andreas-dd/SmartHome/README.md

# SmartHome

## [HB-UNI-Sen-CAP-MOIST-Complete](HB-UNI-Sen-CAP-MOIST-Complete)
Ein kompakter Bodenfeuchtesensor komplett auf einer einzigen Platine inkl. kleinem Gehäuse.
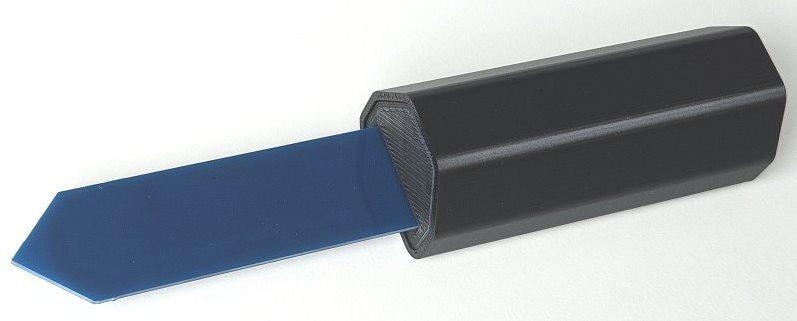
[picture p1: HB-UNI-Sen-CAP-MOIST-Complete/images/Sensor.jpg]
Bild
