andreas-dd/SmartHome/HB-UNI-Sen-CAP-MOIST-Complete/Gehaeuse/Sockel.stl

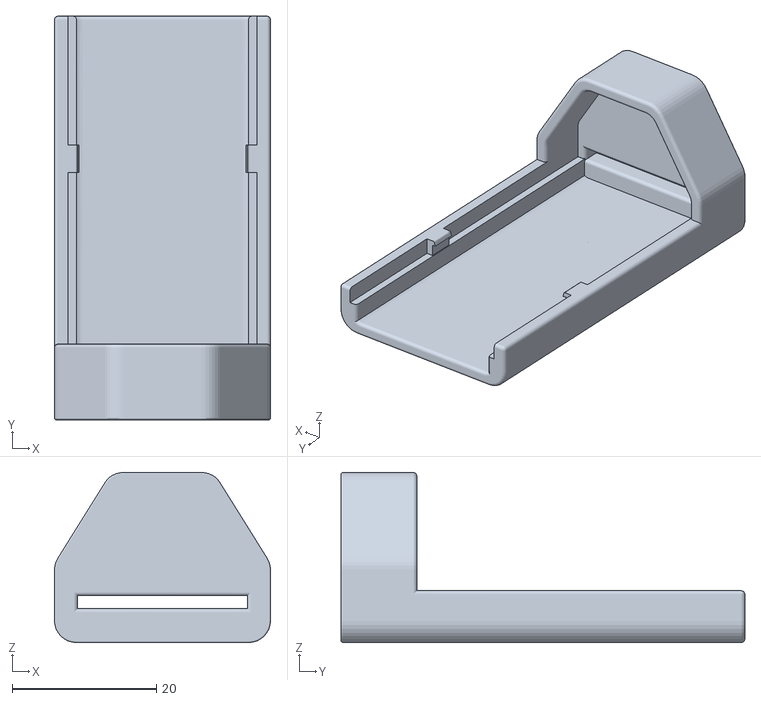
[picture p13: CAD file, 2026-03-24]
HB-UNI-Sen-CAP-MOIST-Complete/Gehaeuse/Sockel.stl
30.0 x 56.0 x 23.6
