andreas-dd/SmartHome/HB-UNI-Sen-CAP-MOIST-Complete/Gehaeuse/Kappe.stl

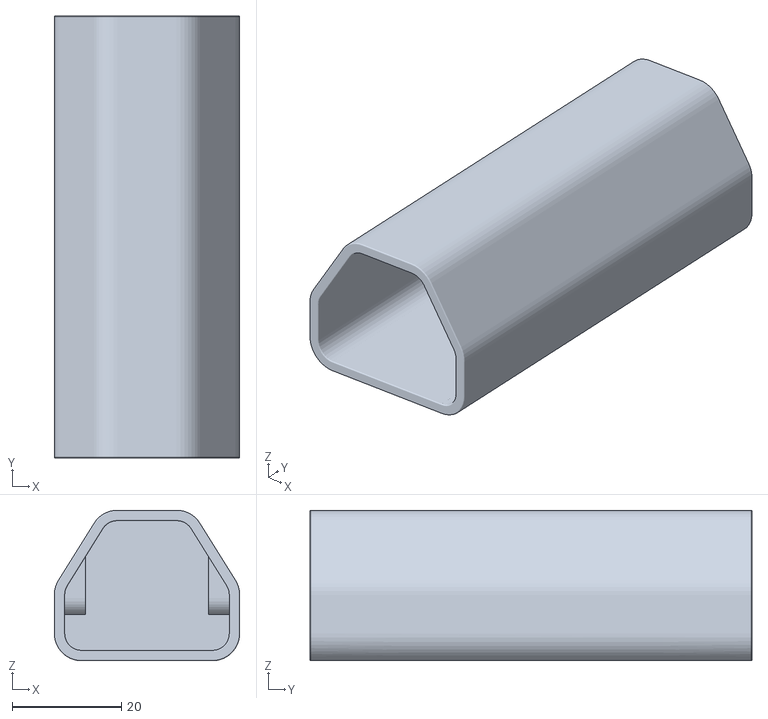
[picture p14: CAD file, 2026-03-24]
HB-UNI-Sen-CAP-MOIST-Complete/Gehaeuse/Kappe.stl
34.0 x 81.0 x 27.6
