andreas-dd/SmartHome/HB-UNI-Sen-CAP-MOIST-Complete/Gehaeuse/Antennenhalter.stl

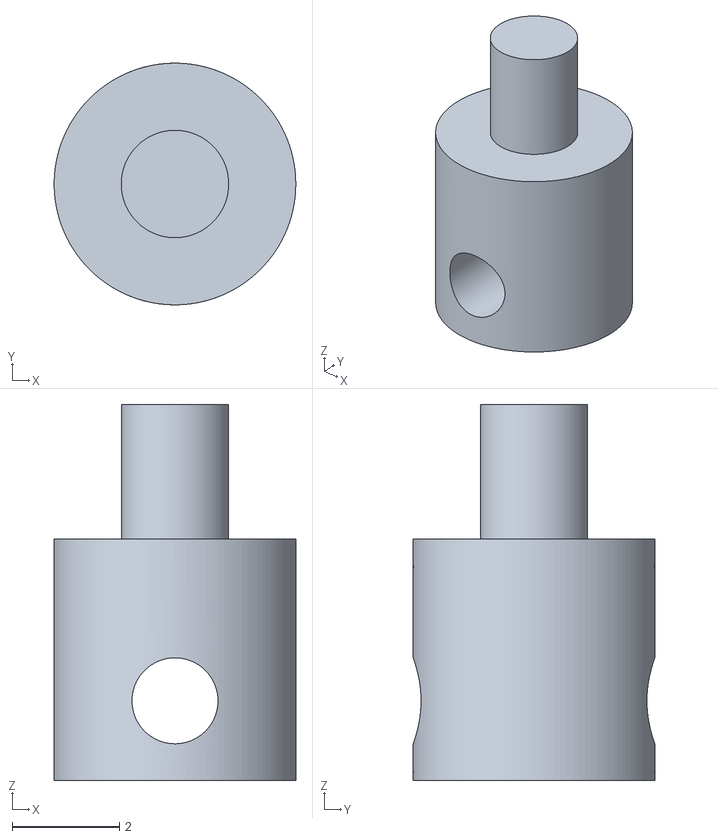
[picture p15: CAD file, 2026-03-24]
HB-UNI-Sen-CAP-MOIST-Complete/Gehaeuse/Antennenhalter.stl
4.50 x 4.50 x 7.00
