andreas-dd/SmartHome/HB-UNI-Sen-CAP-MOIST-Complete/Platine/HB-UNI-Sen-CAP-MOIST-Complete.pdf

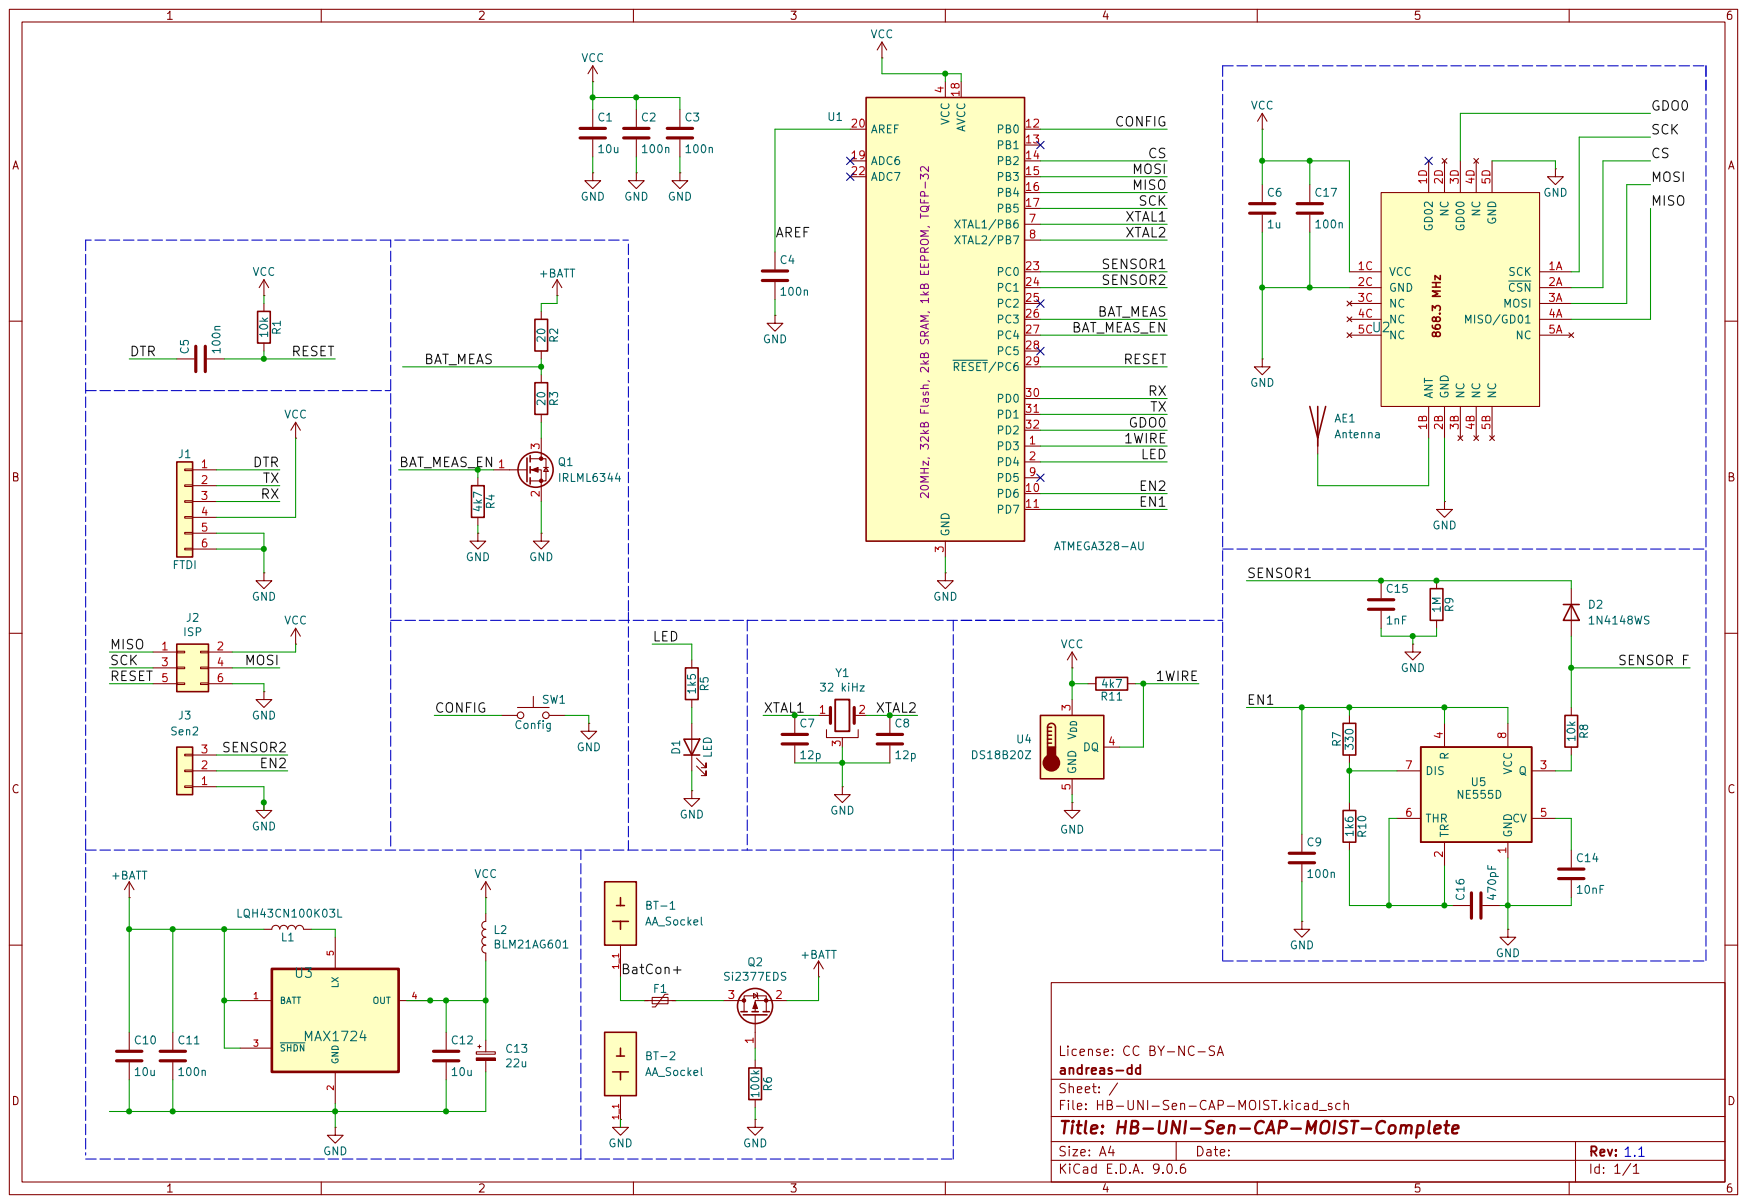
[picture p16: page 1]
