andreas-dd/SmartHome/HB-UNI-Sen-CAP-MOIST-Complete/Platine/Rückseite.pdf

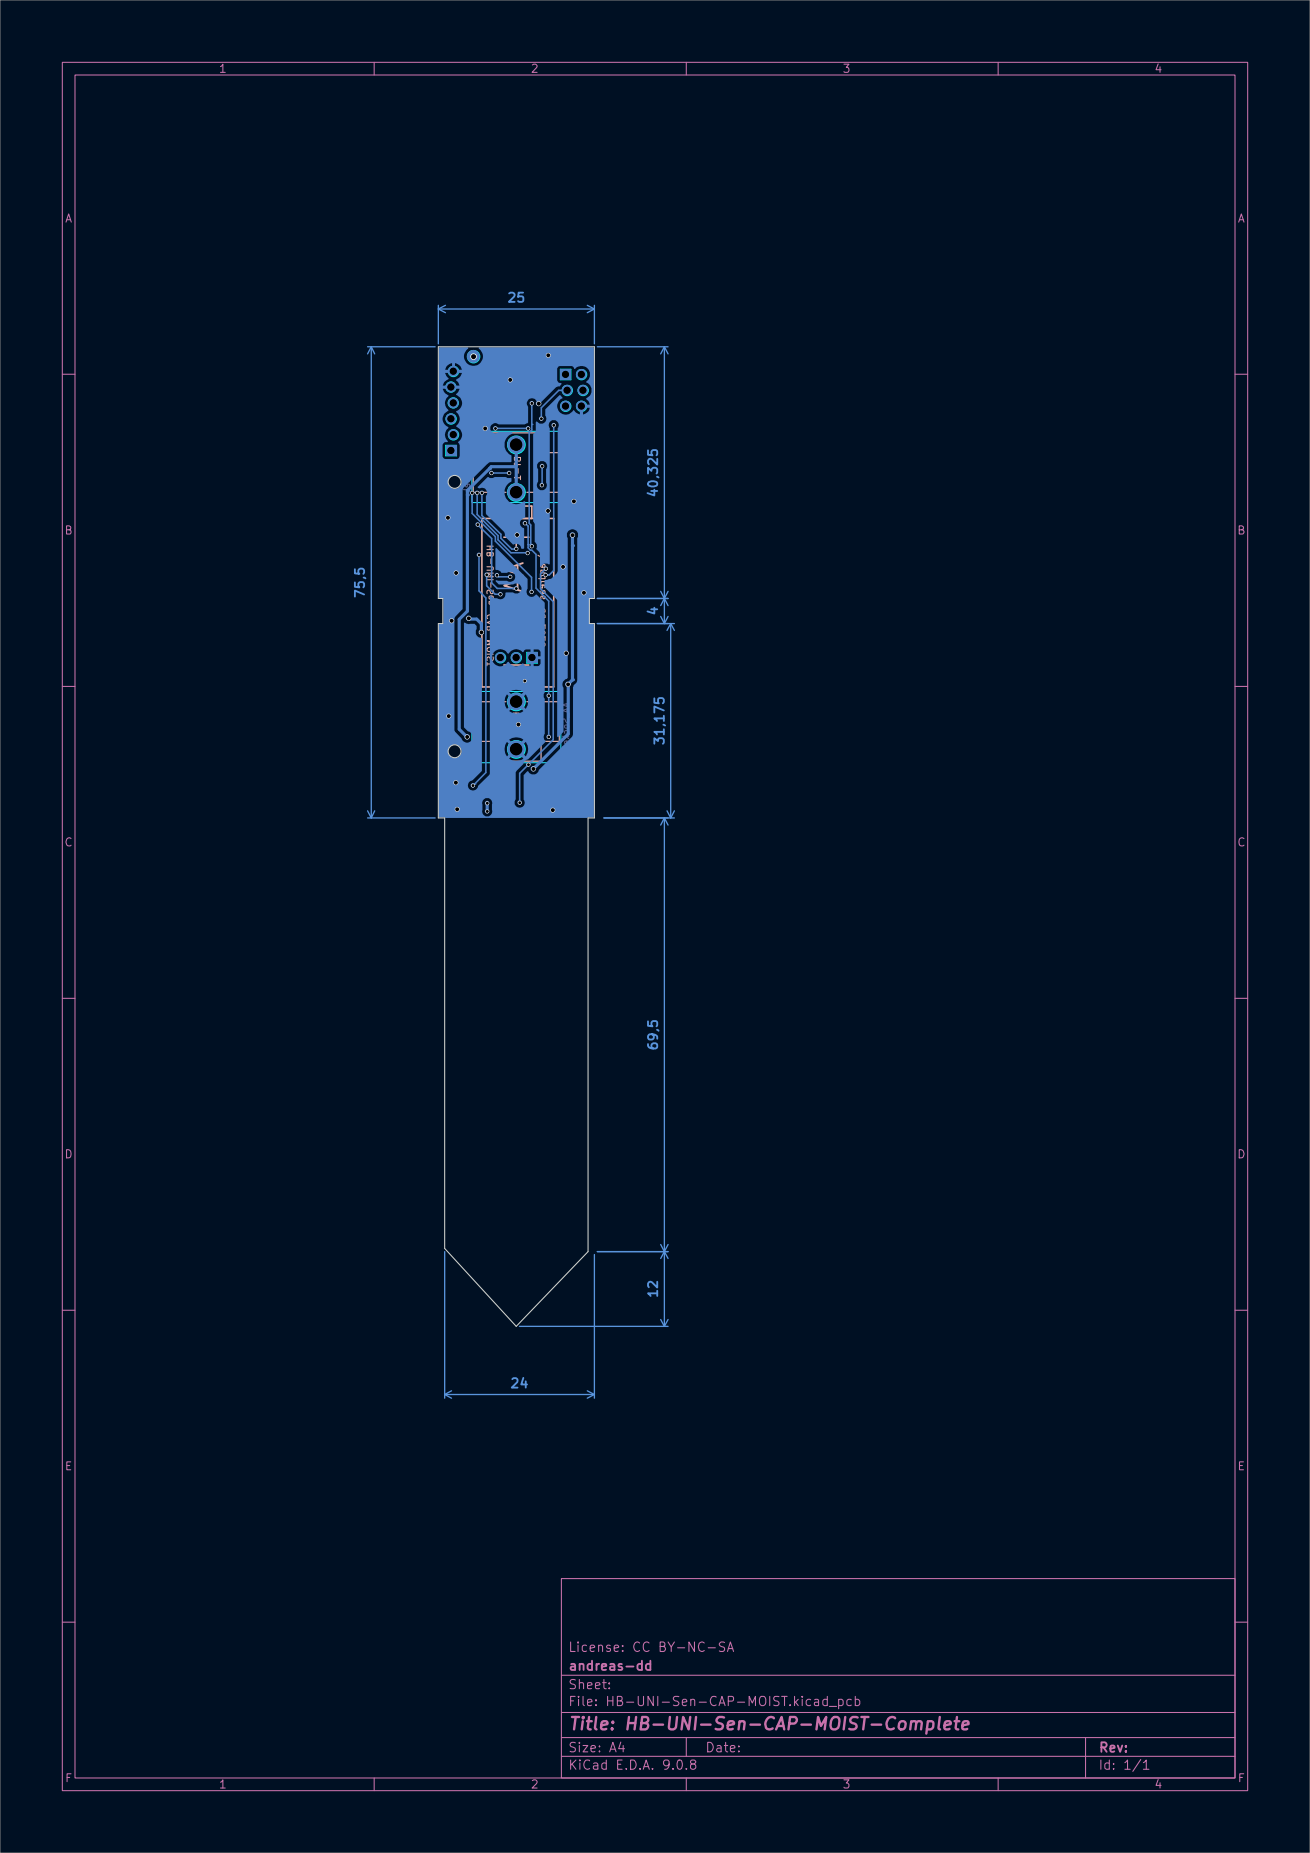
[picture p17: page 1]
