andreas-dd/SmartHome/HB-UNI-Sen-CAP-MOIST-Complete/Platine/Vorderseite.pdf

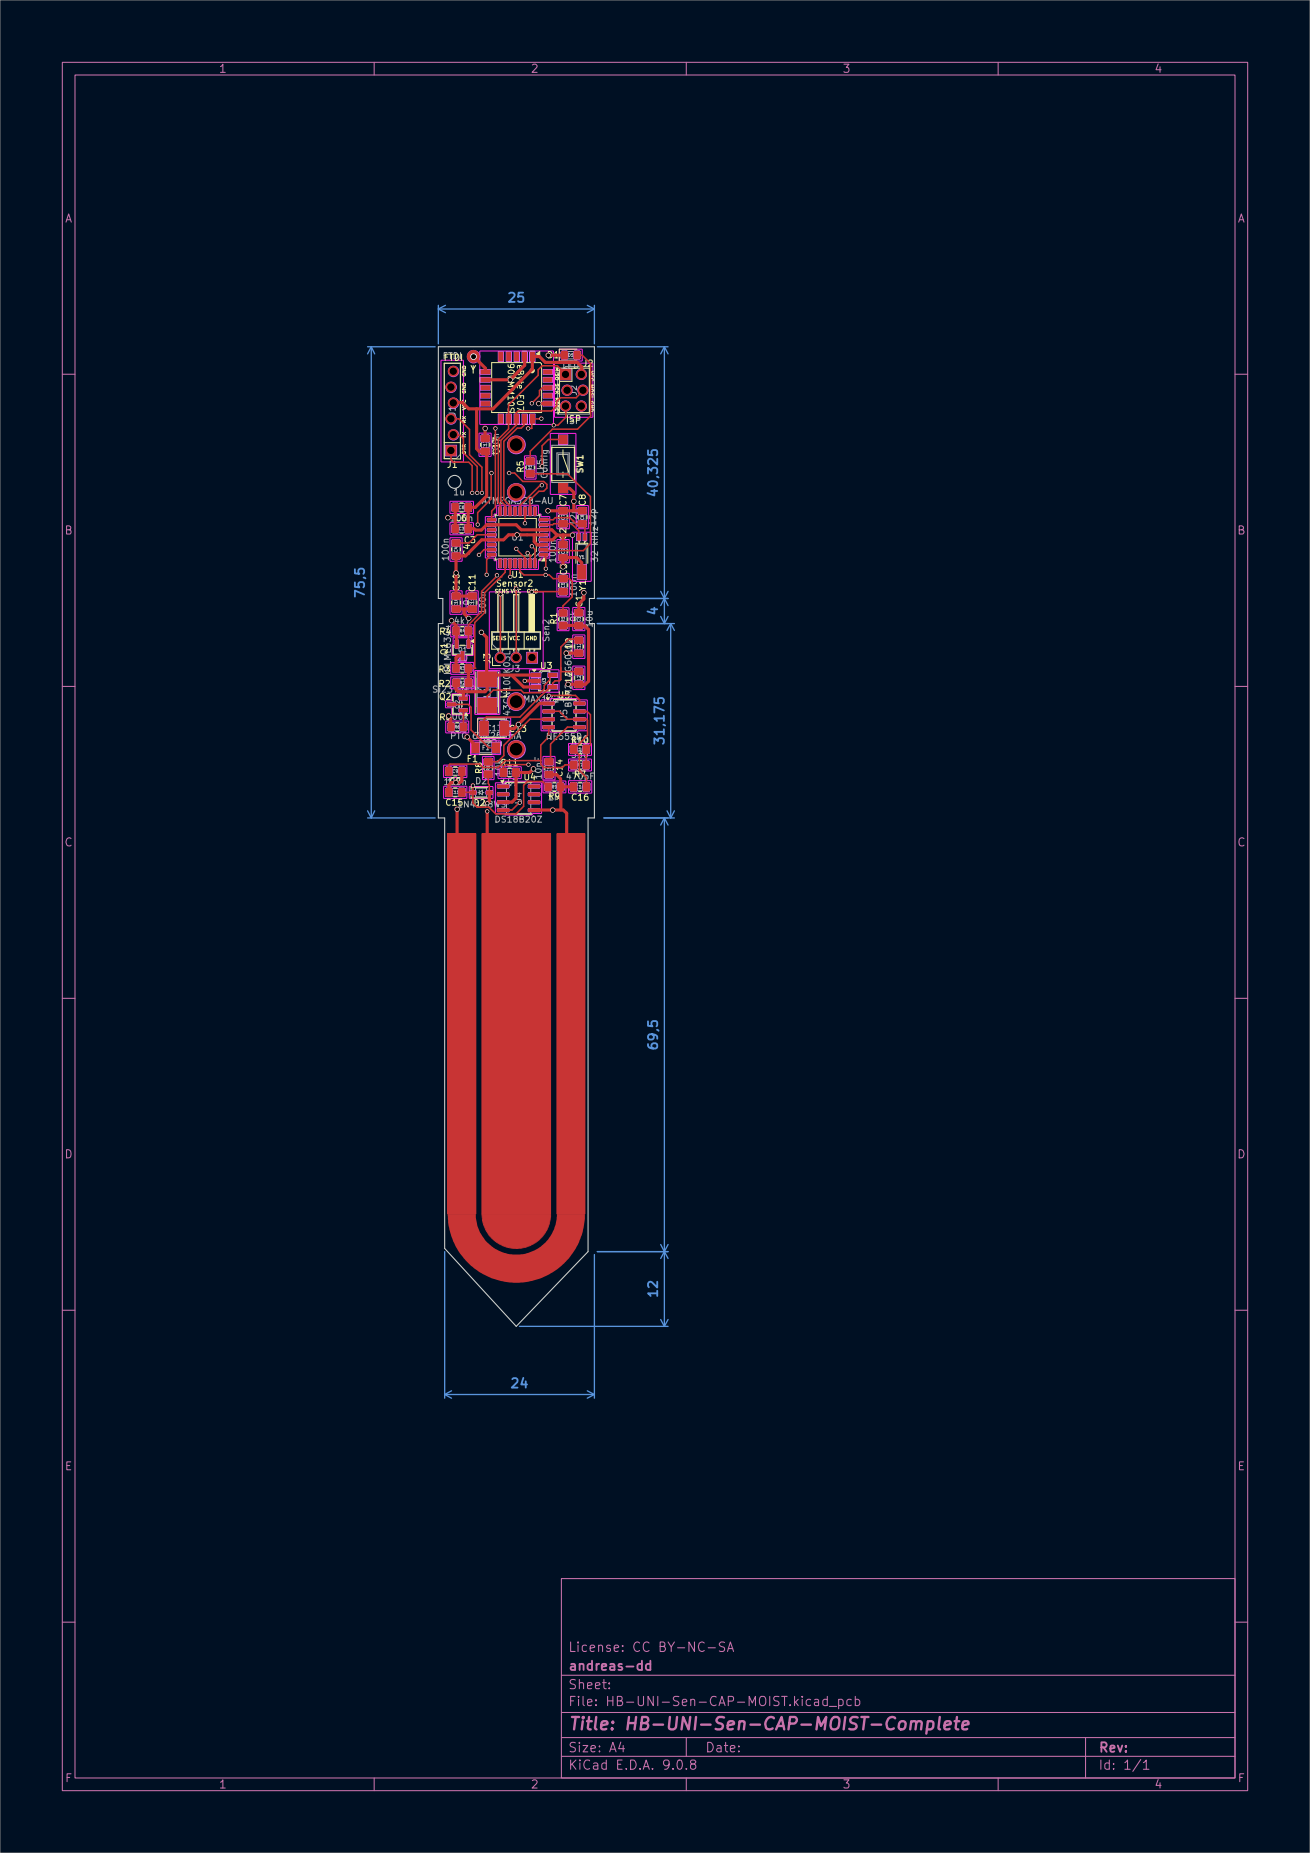
[picture p18: page 1]
