andreas-dd/SmartHome/HB-UNI-Sen-CAP-MOIST-Complete/Platine/HB-UNI-Sen-CAP-MOIST-Complete.kicad_pcb

## KiCad design HB-UNI-Sen-CAP-MOIST-Complete/Platine/HB-UNI-Sen-CAP-MOIST-Complete.kicad_pcb (2026-03-24)

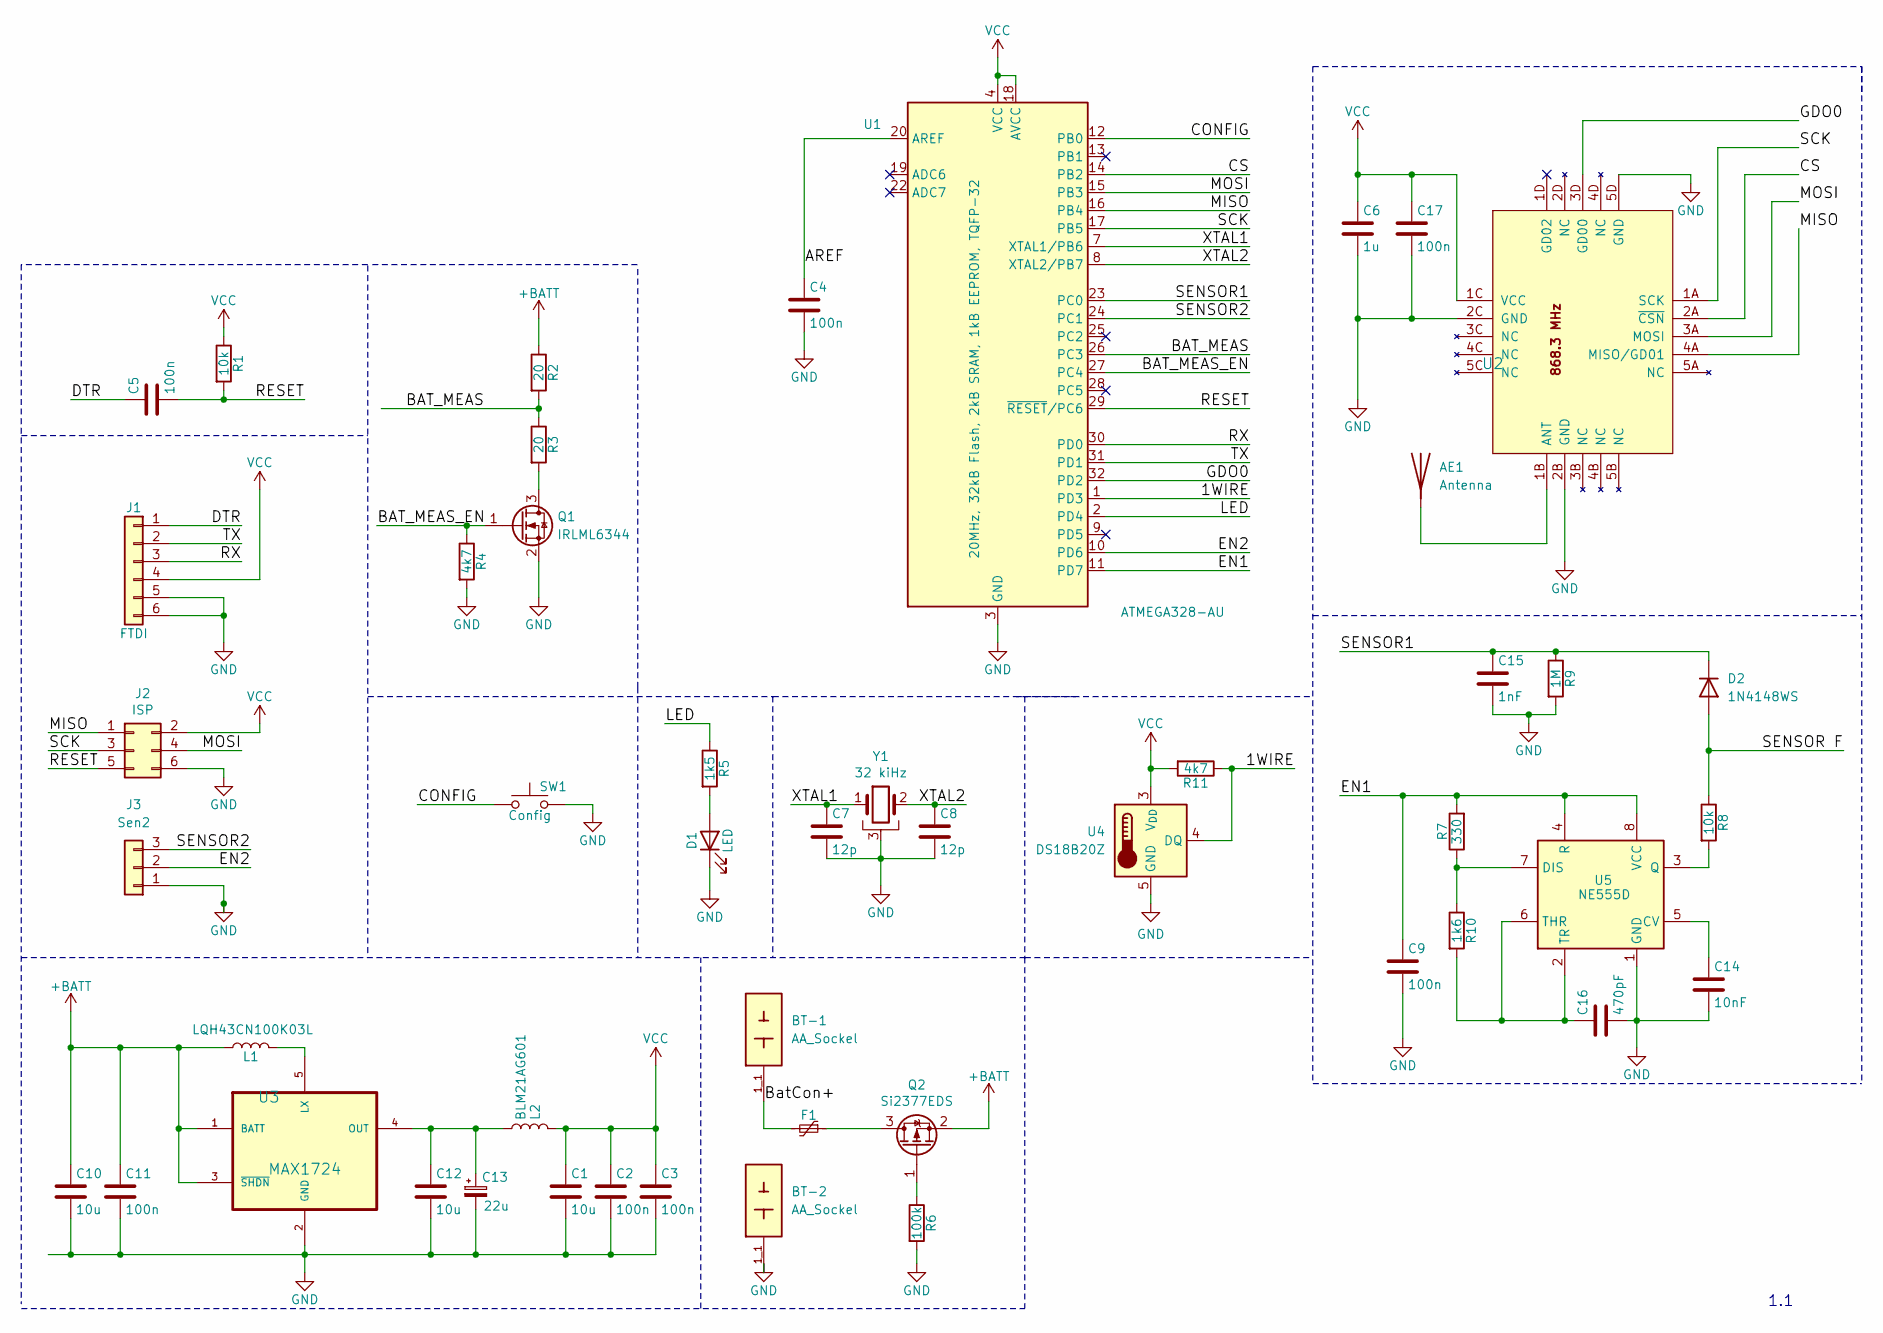
[picture p19: schematic HB-UNI-Sen-CAP-MOIST-Complete.kicad_sch]

Parts:
AE1: Antenna
BT-1, BT-2: AA_Sockel; AA Sockel; PARTREV N
C1, C10, C12: 10u; C_0805_2012Metric_Pad1.18x1.45mm_HandSolder
C2, C3, C4, C5, C9, C11, C17: 100n; C_0805_2012Metric_Pad1.18x1.45mm_HandSolder
C6: 1u; C_0805_2012Metric_Pad1.18x1.45mm_HandSolder
C7, C8: 12p; C_0805_2012Metric_Pad1.18x1.45mm_HandSolder
C13: 22u; CP_EIA-3528-21_Kemet-B_HandSolder
C14: 10nF; C_0805_2012Metric_Pad1.18x1.45mm_HandSolder
C15: 1nF; C_0805_2012Metric_Pad1.18x1.45mm_HandSolder
C16: 470pF; C_0805_2012Metric_Pad1.18x1.45mm_HandSolder
D1: LED; LED_0805_2012Metric_Pad1.15x1.40mm_HandSolder
D2: 1N4148WS; Diode_SOD-323
F1: PTC 6V/250mA; Sicherung_1206_HandSoldering
J1: FTDI; FTDI Arduino Connector
J2: ISP; ISP Connector_2x03_Pitch2.54mm_Tight_Fit
J3: Sen2; Connector Sensor CAP Moist Horizontal
L1: LQH43CN100K03L; Murata RF Inductors
L2: BLM21AG601; C_0805_2012Metric_Pad1.18x1.45mm_HandSolder
Q1: IRLML6344; SOT-23
Q2: Si2377EDS; SOT-23
R1, R8: 10k; R_0805_2012Metric_Pad1.20x1.40mm_HandSolder
R2, R3: 20; R_0805_2012Metric_Pad1.20x1.40mm_HandSolder
R4, R11: 4k7; R_0805_2012Metric_Pad1.20x1.40mm_HandSolder
R5: 1k5; R_0805_2012Metric_Pad1.20x1.40mm_HandSolder
R6: 100k; R_0805_2012Metric_Pad1.20x1.40mm_HandSolder
R7: 330; R_0805_2012Metric_Pad1.20x1.40mm_HandSolder
R9: 1M; R_0805_2012Metric_Pad1.20x1.40mm_HandSolder
R10: 1k6; R_0805_2012Metric_Pad1.20x1.40mm_HandSolder
SW1: Config; SW_SPST_CK_RS282G05A3
U1: ATMEGA328-AU; TQFP-32_7x7mm_P0.8mm; LCSC C14877
U2: CC1101; eByte_E07-900MM10S
U3: MAX1724; SOT-23-5_HandSoldering
U4: DS18B20Z; SOIC-8_3.9x4.9mm_P1.27mm
U5: NE555D; SOIC-8_3.9x4.9mm_P1.27mm
Y1: 32 kiHz; Crystal_SMD_MicroCrystal_MS3V-T1R

Connections:
+BATT: C10.1, C11.1, L1.2, Q2.2 (S), R2.1, U3.1 (BATT), U3.3 (~SHDN)
/1WIRE: R11.1, U1.1 (PD3), U4.4 (DQ)
/AREF: C4.1, U1.20 (AREF)
/BAT_MEAS: R2.2, R3.1, U1.26 (PC3)
/BAT_MEAS_EN: Q1.1 (G), R4.1, U1.27 (PC4)
/BatCon+: BT-1.1_1, BT-1.1_2, F1.2
/CONFIG: SW1.1, U1.12 (PB0)
/CS: U1.14 (PB2), U2.2A (~CSN)
/DTR: C5.1, J1.1
/EN1: C9.1, R7.2, U1.11 (PD7), U5.4 (R), U5.8 (VCC)
/EN2: J3.2, U1.10 (PD6)
/GDO0: U1.32 (PD2), U2.3D (GD00)
/LED: R5.1, U1.2 (PD4)
/MISO: J2.1, U1.16 (PB4), U2.4A (MISO/GD01)
/MOSI: J2.4, U1.15 (PB3), U2.3A (MOSI)
/RESET: C5.2, J2.5, R1.2, U1.29 (~RESET/PC6)
/RX: J1.3, U1.30 (PD0)
/SCK: J2.3, U1.17 (PB5), U2.1A (SCK)
/SENSOR1: C15.1, D2.1 (K), R9.1, U1.23 (PC0)
/SENSOR2: J3.3, U1.24 (PC1)
/SENSOR F: D2.2 (A), R8.1
/TX: J1.2, U1.31 (PD1)
/XTAL1: C7.1, U1.7 (XTAL1/PB6), Y1.1
/XTAL2: C8.1, U1.8 (XTAL2/PB7), Y1.2
GND: BT-2.1_1, BT-2.1_2, C1.2, C2.2, C3.2, C4.2, C6.2, C7.2, C8.2, C9.2, C10.2, C11.2, C12.2, C13.2, C14.2, C15.2, C16.2, C17.2, D1.1 (K), J1.5, J1.6, J2.6, J3.1, Q1.2 (S), R4.2, R6.2, R9.2, SW1.2, U1.3 (GND), U1.5 (GND), U1.21 (GND), U2.2B (GND), U2.2C (GND), U2.5D (GND), U3.2 (GND), U4.5 (GND), U5.1 (GND), Y1.3
unnamed: AE1.1, U2.1B (ANT)
unnamed: D1.2 (A), R5.2
unnamed: Q1.3 (D), R3.2
unnamed: F1.1, Q2.3 (D)
unnamed: Q2.1 (G), R6.1
unnamed: L1.1, U3.5 (LX)
unnamed: C12.1, C13.1, L2.1, U3.4 (OUT)
unnamed: C14.1, U5.5 (CV)
unnamed: R7.1, R10.1, U5.7 (DIS)
unnamed: R8.2, U5.3 (Q)
unnamed: C16.1, R10.2, U5.2 (TR), U5.6 (THR)
VCC: C1.1, C2.1, C3.1, C6.1, C17.1, J1.4, J2.2, L2.2, R1.1, R11.2, U1.4 (VCC), U1.6 (VCC), U1.18 (AVCC), U2.1C (VCC), U4.3 (V_{DD})

Notes on the sheet:
1.1

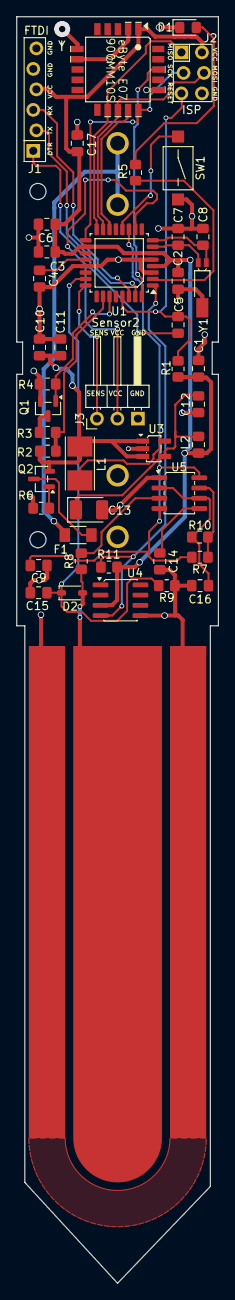
[picture p20: board HB-UNI-Sen-CAP-MOIST-Complete.kicad_pcb from above]

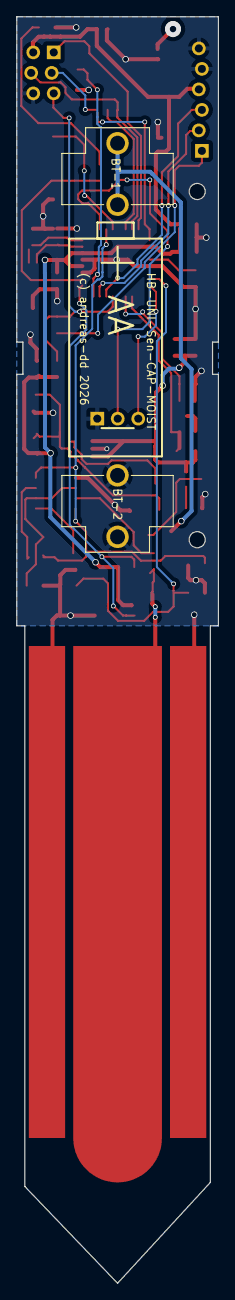
[picture p21: board HB-UNI-Sen-CAP-MOIST-Complete.kicad_pcb from below]

Board: 2 copper layers, 25.0 x 157.0 mm, 47 parts (2 on the bottom side), 36 nets.
