andreas-dd/SmartHome/(notices)

Notices in the files:
HB-UNI-Sen-CAP-MOIST-Complete/Platine/HB-UNI-Sen-CAP-MOIST-Complete.kicad_sch:
License: CC BY-NC-SA
HB-UNI-Sen-CAP-MOIST-Complete/README.md:
License: CC BY-NC-SA 4.0
Creative Commons Lizenzvertrag
parts and their libraries:
Copyright: (c) Andreas Lotze 2025
